johnyb97/ECUS-master/hardware/ECUS-FSE-07.kicad_pcb

## KiCad design hardware/ECUS-FSE-07.kicad_pcb (2018-09-02)

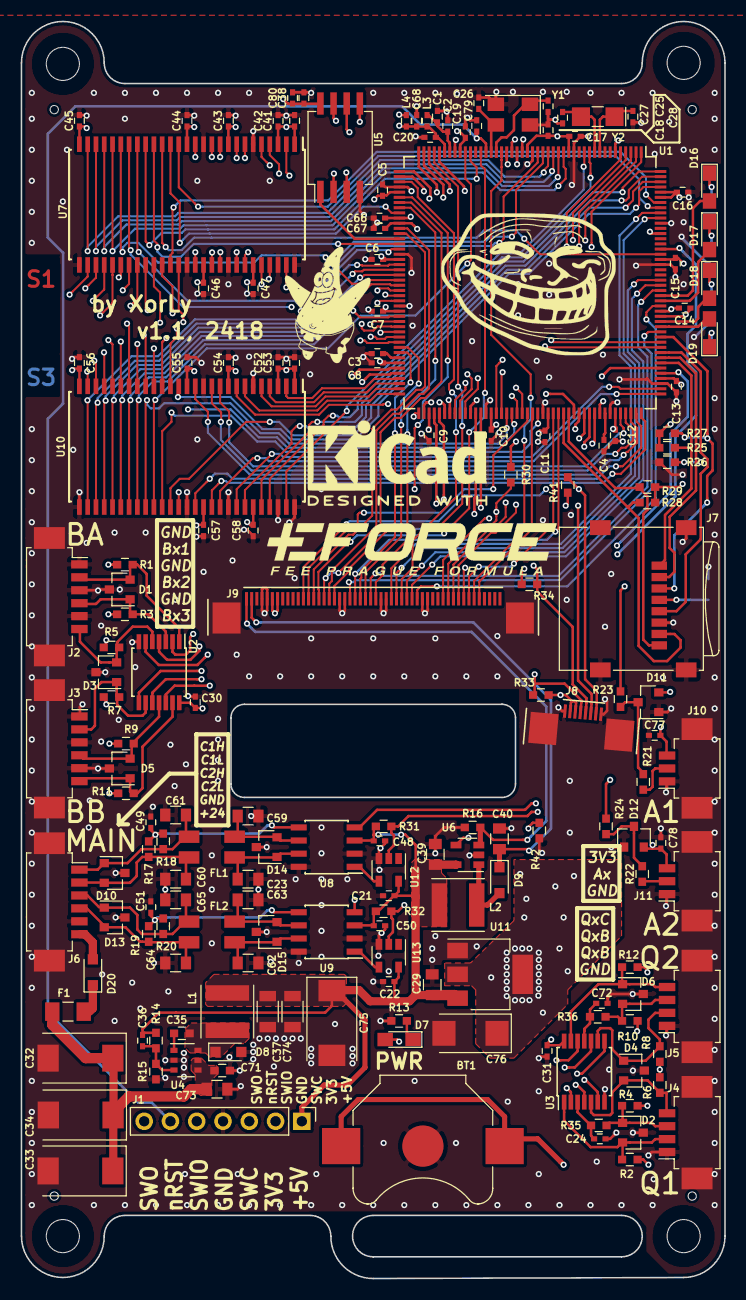
[picture p1: board ECUS-FSE-07.kicad_pcb from above]

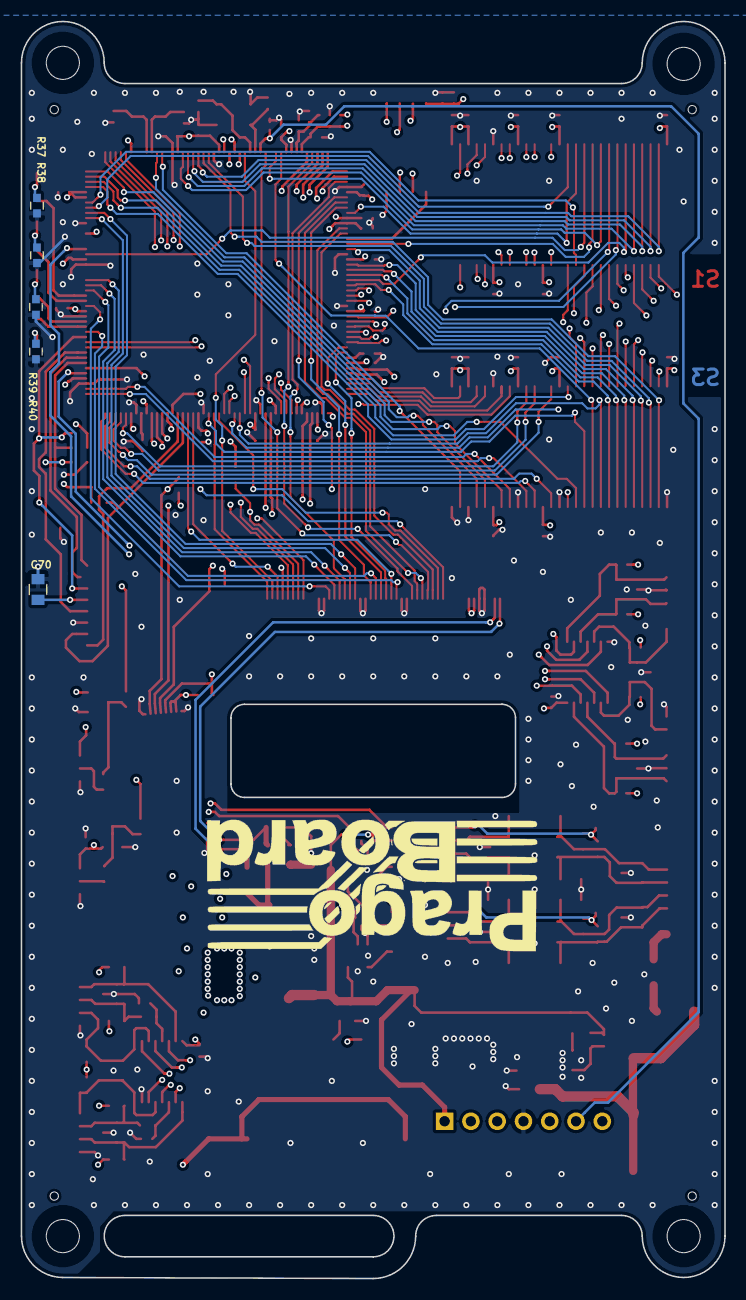
[picture p2: board ECUS-FSE-07.kicad_pcb from below]

Board: 6 copper layers, 68.0 x 121.5 mm, 189 parts (6 on the bottom side), 184 nets.

Parts:
BT1: BR-1225/VCN; Keystone_3000_1x12mm-CoinCell
C1, C3, C4, C68: 2.2u; C_0402_1005Metric_legacy
C2, C5, C6, C7, C8, C9, C10, C11, C12, C13, C14, C15, C16, C17, C18, C19, C20, C21, C22, C24, C30, C31, C36, C38, C48, C50, C72, C79: 100n; C_0402_1005Metric_legacy
C23, C59, C60, C61, C62, C63, C64, C65: Can; C_0805_2012Metric_legacy
C25, C26: 33p; C_0402_1005Metric_legacy
C27, C28: 15p; C_0402_1005Metric_legacy
C29, C39: 4.7u; C_0805_2012Metric_legacy
C32, C33, C34: 10u/35V; CP_EIA-7343-31_Kemet-D
C35: 15n/50V; C_0603_1608Metric_legacy
C37, C74: 10u; C_1206_3216Metric_legacy
C40: 220n/35V; C_0805_2012Metric_legacy
C41, C42, C43, C44, C45, C46, C47, C49, C51, C52, C53, C54, C55, C56, C57, C58: 10n; C_0402_1005Metric_legacy
C66, C67: Cain; C_0402_1005Metric_legacy
C70: 4u; C_0805_2012Metric_legacy
C71: 100n/50V; C_0603_1608Metric_legacy
C73: 1u/50V; C_0805_2012Metric_legacy
C75: 100u/10V; CP_EIA-7343-31_Kemet-D
C76: 22u/16V; CP_EIA-6032-28_Kemet-C_Pad2.24x2.40mm_HandSolder
C77, C78: C; C_0402_1005Metric_legacy
C80: 1u; C_0402_1005Metric_legacy
D1, D2, D3, D4, D5, D6: D_TVS_UNI_x2_CCA; SOT-23
D7: PWR; LED_0805_2012Metric_Pad0.97x1.50mm_HandSolder
D8, D9, D20: D_Schottky; D_SOD-323_HandSoldering
D10, D13, D14, D15: NUP2105L; SOT-23
D11, D12: BAV99; SOT-23
D16: LED1; LED_0805_2012Metric_Pad0.97x1.50mm_HandSolder
D17: LED2; LED_0805_2012Metric_Pad0.97x1.50mm_HandSolder
D18: LED3; LED_0805_2012Metric_Pad0.97x1.50mm_HandSolder
D19: LED4; LED_0805_2012Metric_Pad0.97x1.50mm_HandSolder
F1: Fuse; Fuse_1206_3216Metric_Pad1.39x1.80mm_HandSolder
FL1, FL2: EMI_Filter_LL; DLW43
J1: DBG; PinHeader_1x07_P2.54mm_Vertical
J2: BTN_A; Molex_PicoBlade_53261-0671_1x06-1MP_P1.25mm_Horizontal
J3: BTN_B; Molex_PicoBlade_53261-0671_1x06-1MP_P1.25mm_Horizontal
J4: QEI1; Molex_PicoBlade_53261-0471_1x04-1MP_P1.25mm_Horizontal
J5: QEI2; Molex_PicoBlade_53261-0471_1x04-1MP_P1.25mm_Horizontal
J6: main; Molex_PicoBlade_53261-0671_1x06-1MP_P1.25mm_Horizontal
J7: Micro_SD_Card_Det; microSD_HC_Wuerth_693072010801
J8: TC; FPC_08_0.5
J9: LCD; FPC_50_0.5
J10, J11: AIN; Molex_PicoBlade_53261-0371_1x03-1MP_P1.25mm_Horizontal
L1: 6.8u; L_Taiyo-Yuden_NR-50xx
L2: 33u; L_Taiyo-Yuden_NR-50xx
L3, L4: Ferrite_Bead_Small; C_0402_1005Metric_legacy
M1: DISPLAY_MODEL; LCD_ECUS
M2: eforce; eforce_28
M3: pragoboard
M4: bonus; troll_24
M5: kicad; kicad_18
M6: patrick; patrick_11
MK1, MK2, MK3, MK4: Mounting_Hole; MountingHole_3.2mm_M3_NoMask
MK5, MK6, MK7, MK8: LCD_Hole; Hole_0.8
R1, R2, R3, R4, R5, R6, R7, R8, R9, R10, R11, R12, R31, R32, R35, R36, R42: 1k; R_0603_larger_pads
R13, R37, R38, R39, R40: Rled; R_0603_larger_pads
R14: 3.9k; R_0603_larger_pads
R15: 680; R_0603_larger_pads
R16: 15; R_0603_larger_pads
R17, R18, R19, R20: 60; R_0603_larger_pads
R21, R22: Rain; R_0603_larger_pads
R23, R24: Rain2; R_0603_larger_pads
R25, R27, R28, R29: RuSD; R_0603_larger_pads
R26: RdSD; R_0603_larger_pads
R30, R41: 10k; R_0603_larger_pads
R33, R34: 4.7k; R_0603_larger_pads
U1: STM32F746IETx; LQFP-176_24x24mm_P0.5mm
U2, U3: 74LVC04; TSSOP-14_4.4x5mm_P0.65mm
U4: BD9G101G; TSOP-6_1.65x3.05mm_P0.95mm
U5: N25Q128A; SSO-8_6.8x5.9mm_P1.27mm_Clearance7mm
U6: CAT4237; SOT-23-5
U7, U10: IS42S16400; TSOP_II_54_10.16x22.22_Pitch0.8mm
U8, U9: TJA1049T; SOIC-8_3.9x4.9mm_P1.27mm
U11: AP1117-33; SOT-223-3_TabPin2
U12, U13: 74LVC1G17; SOT-23-5
Y1: 8MHz 18pF; Crystal_SMD_5032-4Pin_5.0x3.2mm
Y2: 32.768 kHz 9pF; Crystal_SMD_MicroCrystal_CC7V-T1A-2Pin_3.2x1.5mm_HandSolder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

Connections:
+3V3: C5.1, C6.1, C7.1, C8.1, C9.1, C10.1, C11.1, C12.1, C13.1, C14.1, C15.1, C16.1, C17.1, C18.1, C19.1, C30.1, C31.1, C38.1, C41.1, C42.1, C43.1, C44.1, C45.1, C46.1, C47.1, C52.1, C53.1, C54.1, C55.1, C56.1, C57.1, C58.1, C70.1, C76.1, C77.2, C78.2, C80.1, D7.2, D11.2, D12.2, J1.2, J7.4, J8.2, J8.3, J9.6, J9.7, J10.3, J11.3, L4.2, R1.1, R2.1, R3.1, R4.1, R5.1, R6.1, R7.1, R8.1, R9.1, R10.1, R11.1, R12.1, R25.1, R27.1, R28.1, R29.1, R30.1, R33.1, R34.1, R41.1, U1.15, U1.23, U1.36, U1.49, U1.62, U1.72, U1.82, U1.91, U1.103, U1.114, U1.127, U1.136, U1.149, U1.159, U1.171, U1.172, U2.14, U3.14, U5.8, U7.1, U7.3, U7.9, U7.14, U7.27, U7.43, U7.49, U10.1, U10.3, U10.9, U10.14, U10.27, U10.43, U10.49, U11.2
+5V: C21.1, C22.1, C29.1, C36.1, C37.1, C39.1, C48.1, C50.1, C74.1, C75.1, J1.1, L1.2, L2.1, R14.1, R31.1, R32.1, U6.5, U8.3, U9.3, U11.3, U12.5, U13.5
+24V: C32.1, C33.1, C34.1, C71.1, C73.1, F1.2, U4.4, U4.5
/AIN_1: C66.2, R23.2, U1.54
/AIN_2: C67.2, R24.2, U1.55
/BTN_A1: U1.83, U2.2
/BTN_A2: U1.84, U2.4
/BTN_A3: U1.94, U2.6
/BTN_B1: U1.95, U2.8
/BTN_B2: U1.99, U2.10
/BTN_B3: U1.119, U2.12
/CAN1_H: C60.1, D10.2, FL1.2, J6.2, R17.1
/CAN1_L: C61.1, D10.1, FL1.4, J6.1, R18.2
/CAN1_RX: U1.122, U8.4
/CAN1_TX: R31.2, U1.123, U12.2
/CAN2_H: C64.1, D13.2, FL2.2, J6.4, R19.1
/CAN2_L: C65.1, D13.1, FL2.4, J6.3, R20.2
/CAN2_RX: U1.92, U9.4
/CAN2_TX: R32.2, U1.93, U13.2
/FLASH_CLK: U1.58, U5.1
/FLASH_IO0: U1.26, U5.5
/FLASH_IO1: U1.27, U5.2
/FLASH_IO2: U1.25, U5.3
/FLASH_IO3: U1.24, U5.7
/FLASH_nCS: U1.164, U5.6
/I2C4_SCL: J8.4, R33.2, U1.100
/I2C4_SDA: J8.5, R34.2, U1.101
/LCD/LED_A: C40.1, D9.1, J9.2
/LCD/LED_K: J9.1, R16.1, U6.3
/LCD_B2: J9.34, U1.150
/LCD_B3: J9.33, U1.154
/LCD_B4: J9.32, U1.155
/LCD_B5: J9.31, U1.47
/LCD_B6: J9.30, U1.167
/LCD_B7: J9.29, U1.168
/LCD_BLCTL: R42.1, U1.138, U6.4
/LCD_CLK: J9.46, U1.111
/LCD_CTL_MISO: J9.42, U1.4
/LCD_CTL_MOSI: J9.41, U1.5
/LCD_CTL_RST: J9.12, U1.2
/LCD_CTL_SCK: J9.39, U1.1
/LCD_CTL_~CS: J9.40, R30.2, U1.3
/LCD_DE: J9.45, U1.28
/LCD_G2: J9.26, U1.52
/LCD_G3: J9.25, U1.153
/LCD_G4: J9.24, U1.79
/LCD_G5: J9.23, U1.80
/LCD_G6: J9.22, U1.116
/LCD_G7: J9.21, U1.145
/LCD_HSYNC: J9.44, U1.115
/LCD_R2: J9.18, U1.41
/LCD_R3: J9.17, U1.56
/LCD_R4: J9.16, U1.51
/LCD_R5: J9.15, U1.32
/LCD_R6: J9.14, U1.57
/LCD_R7: J9.13, U1.110
/LCD_VSYNC: J9.43, U1.50
/LED1: D16.2, U1.152
/LED2: D17.2, U1.151
/LED3: D18.2, U1.147
/LED4: D19.2, U1.146
/QE1_A: U1.40, U3.2
/QE1_B: U1.42, U3.4
/QE1_C: U1.43, U3.6
/QE2_A: U1.44, U3.8
/QE2_B: U1.45, U3.10
/QE2_C: U1.46, U3.12
/RAM_A0: U1.16, U7.23, U10.23
/RAM_A1: U1.17, U7.24, U10.24
/RAM_A2: U1.18, U7.25, U10.25
/RAM_A3: U1.19, U7.26, U10.26
/RAM_A4: U1.20, U7.29, U10.29
/RAM_A5: U1.21, U7.30, U10.30
/RAM_A6: U1.60, U7.31, U10.31
/RAM_A7: U1.63, U7.32, U10.32
/RAM_A8: U1.64, U7.33, U10.33
/RAM_A9: U1.65, U7.34, U10.34
/RAM_A10: U1.66, U7.22, U10.22
/RAM_A11: U1.67, U7.35, U10.35
/RAM_A12: U1.106, U7.36, U10.36
/RAM_A13: U1.107, U7.40, U10.40
/RAM_BA0: U1.108, U7.20, U10.20
/RAM_BA1: U1.109, U7.21, U10.21
/RAM_CAS: U1.160, U7.17, U10.17
/RAM_CKE: U1.35, U7.37, U10.37
/RAM_CLK: U1.112, U7.38, U10.38
/RAM_CS: U1.34, U7.19, U10.19
/RAM_DE0: U1.169, U7.15
/RAM_DE1: U1.170, U7.39
/RAM_DE2: U1.173, U10.15
/RAM_DE3: U1.174, U10.39
/RAM_DH0: U1.85, U10.2
/RAM_DH1: U1.86, U10.4
/RAM_DH2: U1.87, U10.5
/RAM_DH3: U1.88, U10.7
/RAM_DH4: U1.89, U10.8
/RAM_DH5: U1.128, U10.10
/RAM_DH6: U1.129, U10.11
/RAM_DH7: U1.130, U10.13
/RAM_DH8: U1.131, U10.42
/RAM_DH9: U1.132, U10.44
/RAM_DH10: U1.133, U10.45
/RAM_DH11: U1.134, U10.47
/RAM_DH12: U1.175, U10.48
/RAM_DH13: U1.176, U10.50
/RAM_DH14: U1.11, U10.51
/RAM_DH15: U1.12, U10.53
/RAM_DL0: U1.104, U7.2
/RAM_DL1: U1.105, U7.4
/RAM_DL2: U1.142, U7.5
/RAM_DL3: U1.143, U7.7
/RAM_DL4: U1.68, U7.8
/RAM_DL5: U1.69, U7.10
/RAM_DL6: U1.70, U7.11
/RAM_DL7: U1.73, U7.13
/RAM_DL8: U1.74, U7.42
/RAM_DL9: U1.75, U7.44
/RAM_DL10: U1.76, U7.45
/RAM_DL11: U1.77, U7.47
/RAM_DL12: U1.78, U7.48
/RAM_DL13: U1.96, U7.50
/RAM_DL14: U1.97, U7.51
/RAM_DL15: U1.98, U7.53
/RAM_RAS: U1.59, U7.18, U10.18
/RAM_WE: U1.53, U7.16, U10.16
/SD_CLK: J7.5, U1.141
/SD_CMD: J7.3, R27.2, U1.144
/SD_DAT0: J7.7, R28.2, U1.117
/SD_DAT1: J7.8, R29.2, U1.118
/SD_DAT2: J7.1, R25.2, U1.139
/SD_DAT3: J7.2, R26.1, U1.140
/SWCLK: J1.3, U1.137
/SWDIO: J1.5, U1.124
/SWO: J1.7, U1.161
/TC_INT: J8.6, U1.120
/TC_RST: J8.7, R41.2, U1.121
/VDDA: C20.1, C68.1, L3.1, L4.1, U1.39
/XTAL32_IN: C27.1, U1.9, Y2.1
/XTAL32_OUT: C28.1, U1.10, Y2.2
/XTAL_IN: C25.1, U1.29, Y1.1
/XTAL_OUT: C26.1, U1.30, Y1.3
/nRST: C79.1, J1.6, U1.31
GND: BT1.2, C1.2, C2.2, C3.2, C4.2, C5.2, C6.2, C7.2, C8.2, C9.2, C10.2, C11.2, C12.2, C13.2, C14.2, C15.2, C16.2, C17.2, C18.2, C19.2, C20.2, C21.2, C22.2, C23.2, C24.2, C25.2, C26.2, C27.2, C28.2, C29.2, C30.2, C31.2, C32.2, C33.2, C34.2, C37.2, C38.2, C39.2, C40.2, C41.2, C42.2, C43.2, C44.2, C45.2, C46.2, C47.2, C48.2, C49.2, C50.2, C51.2, C52.2, C53.2, C54.2, C55.2, C56.2, C57.2, C58.2, C59.2, C60.2, C61.2, C62.2, C63.2, C64.2, C65.2, C66.1, C67.1, C68.2, C70.2, C71.2, C72.2, C73.2, C74.2, C75.2, C76.2, C77.1, C78.1, C79.2, C80.2, D1.3, D2.3, D3.3, D4.3, D5.3, D6.3, D8.2, D10.3, D11.1, D12.1, D13.3, D14.3, D15.3, J1.4, J2.1, J2.3, J2.5, J2.MP, J3.1, J3.3, J3.5, J3.MP, J4.1, J4.MP, J5.1, J5.MP, J6.5, J6.MP, J7.6, J7.9, J8.1, J8.8, J8.MP, J9.4, J9.5, J9.19, J9.20, J9.27, J9.28, J9.35, J9.36, J9.MP, J10.1, J10.MP, J11.1, J11.MP, R13.2, R15.2, R16.2, R26.2, R37.2, R38.2, R39.2, R40.2, R42.2, U1.14, U1.22, U1.37, U1.48, U1.61, U1.71, U1.90, U1.102, U1.113, U1.126, U1.135, U1.148, U1.158, U1.166, U2.7, U3.7, U4.2, U5.4, U6.2, U7.6, U7.12, U7.28, U7.41, U7.46, U7.52, U7.54, U8.2, U8.8, U9.2, U9.8, U10.6, U10.12, U10.28, U10.41, U10.46, U10.52, U10.54, U11.1, U12.3, U13.3, Y1.2, Y1.4
unnamed: BT1.1, U1.6
unnamed: C1.1, C2.1, L3.2, U1.38
unnamed: C3.1, U1.81
unnamed: C4.1, U1.125
unnamed: C23.1, D14.1, FL1.1, U8.7
unnamed: C24.1, R35.1, U3.3
unnamed: C35.1, D8.1, L1.1, U4.6
unnamed: C35.2, U4.1
unnamed: C36.2, R14.2, R15.1, U4.3
unnamed: C49.1, R17.2, R18.1, U8.5
unnamed: C51.1, R19.2, R20.1, U9.5
unnamed: C59.1, D14.2, FL1.3, U8.6
unnamed: C62.1, D15.1, FL2.1, U9.7
unnamed: C63.1, D15.2, FL2.3, U9.6
unnamed: C72.1, R36.1, U3.11
unnamed: D1.1, J2.4, R3.2, U2.3
unnamed: D1.2, J2.2, R1.2, U2.1
unnamed: D2.1, J4.3, R4.2, R35.2
unnamed: D2.2, J4.2, R2.2, U3.1
unnamed: D3.1, J3.2, R7.2, U2.9
unnamed: D3.2, J2.6, R5.2, U2.5
unnamed: D4.1, J5.2, R8.2, U3.9
unnamed: D4.2, J4.4, R6.2, U3.5
unnamed: D5.1, J3.6, R11.2, U2.13
unnamed: D5.2, J3.4, R9.2, U2.11
unnamed: D6.1, J5.4, R12.2, U3.13
unnamed: D6.2, J5.3, R10.2, R36.2
unnamed: D7.1, R13.1
unnamed: D9.2, L2.2, U6.1
unnamed: D11.3, R21.2, R23.1
unnamed: D12.3, R22.2, R24.1
unnamed: D16.1, R37.1
unnamed: D17.1, R38.1
unnamed: D18.1, R39.1
unnamed: D19.1, R40.1
unnamed: D20.1, F1.1
unnamed: D20.2, J6.6
unnamed: J10.2, R21.1
unnamed: J11.2, R22.1
unnamed: U8.1, U12.4
unnamed: U9.1, U13.4
