johnyb97/ECUS-master/code/candb_structure.c

//by xorly

#include "candb_structure.h"

#ifndef NULL
	#define NULL ( (void *) 0)
#endif


const candb_descrition_map_t *const ECUA_AIRsState_descriptions[]={
	(const candb_descrition_map_t[]){{ CANDB_ECUA_AIRSSTATE_ECUA_PENDINGCHARGERDETECT, "Awaiting detection of car or charger" }},
	(const candb_descrition_map_t[]){{ CANDB_ECUA_AIRSSTATE_ECUA_READY, "Awaiting SDC completion to begin precharge" }},
	(const candb_descrition_map_t[]){{ CANDB_ECUA_AIRSSTATE_ECUA_STARTUPCHECK, "Startup check" }},
	(const candb_descrition_map_t[]){{ CANDB_ECUA_AIRSSTATE_ECUA_PRECHARGECLOSING, "Precharge relay is being closed" }},
	(const candb_descrition_map_t[]){{ CANDB_ECUA_AIRSSTATE_ECUA_HVMCLOSING, "HV- relay is being closed" }},
	(const candb_descrition_map_t[]){{ CANDB_ECUA_AIRSSTATE_ECUA_PRECHARGING, "Precharge part 1: blind delay" }},
	(const candb_descrition_map_t[]){{ CANDB_ECUA_AIRSSTATE_ECUA_WAITINGFORVDIFF, "Precharge part 2: wait for ΔV to approach zero" }},
	(const candb_descrition_map_t[]){{ CANDB_ECUA_AIRSSTATE_ECUA_HVPCLOSING, "HV+ relay is being closed" }},
	(const candb_descrition_map_t[]){{ CANDB_ECUA_AIRSSTATE_ECUA_ENDPRECHARGE, "Precharge is finishing" }},
	(const candb_descrition_map_t[]){{ CANDB_ECUA_AIRSSTATE_ECUA_TSACTIVE, "TS is charged and active" }},
	(const candb_descrition_map_t[]){{ CANDB_ECUA_AIRSSTATE_ECUA_FATALERROR, "A fatal error occured and the AMS is latched" }},
	(const candb_descrition_map_t[]){{ CANDB_ECUA_AIRSSTATE_ECUA_COOLDOWN, "Precharge failed, cooling down before retrying" }},
	(const candb_descrition_map_t[]){{ CANDB_ECUA_AIRSSTATE_ECUA_HVMCOOLDOWN, "HV- failed to close, cooling down before retrying" }},
NULL};
const candb_descrition_map_t *const ECUA_StateAMS_descriptions[]={
	(const candb_descrition_map_t[]){{ CANDB_ECUA_STATEAMS_ECUA_ALL_OK, "without_fault" }},
	(const candb_descrition_map_t[]){{ CANDB_ECUA_STATEAMS_ECUA_SHIT, "All_fucked" }},
NULL};
const candb_descrition_map_t *const ECUA_ErrorCode_descriptions[]={
	(const candb_descrition_map_t[]){{ CANDB_ECUA_ERRORCODE_ECUA_OK, "no error" }},
	(const candb_descrition_map_t[]){{ CANDB_ECUA_ERRORCODE_ECUA_SDC_TIMEOUT, "unused" }},
	(const candb_descrition_map_t[]){{ CANDB_ECUA_ERRORCODE_ECUA_HVM_MELT, "HV- closed even though it shouldn't be" }},
	(const candb_descrition_map_t[]){{ CANDB_ECUA_ERRORCODE_ECUA_HVP_MELT, "HV+ closed even though it shouldn't be" }},
	(const candb_descrition_map_t[]){{ CANDB_ECUA_ERRORCODE_ECUA_HVM_TIMEOUT, "HV- didn't close in time" }},
	(const candb_descrition_map_t[]){{ CANDB_ECUA_ERRORCODE_ECUA_HVP_TIMEOUT, "HV+ didn't close in time" }},
	(const candb_descrition_map_t[]){{ CANDB_ECUA_ERRORCODE_ECUA_VDIFF_TIMEOUT, "precharge failed to equaize AIRs x Accu voltage" }},
	(const candb_descrition_map_t[]){{ CANDB_ECUA_ERRORCODE_ECUA_SDC_INTERRUPTED, "SDC interrupted unexpectedly" }},
	(const candb_descrition_map_t[]){{ CANDB_ECUA_ERRORCODE_ECUA_HVM_DISCONNECT, "HV- broke open" }},
	(const candb_descrition_map_t[]){{ CANDB_ECUA_ERRORCODE_ECUA_HVP_DISCONNECT, "HV+ broke open" }},
	(const candb_descrition_map_t[]){{ CANDB_ECUA_ERRORCODE_ECUA_BMS_CELL_MIN_VOLTAGE, "Voltage of a cell is too low" }},
	(const candb_descrition_map_t[]){{ CANDB_ECUA_ERRORCODE_ECUA_BMS_CELL_BALANCE, "Imbalance between some cells is too high" }},
	(const candb_descrition_map_t[]){{ CANDB_ECUA_ERRORCODE_ECUA_BMS_CELL_TEMPERATURE, "Too hot!" }},
	(const candb_descrition_map_t[]){{ CANDB_ECUA_ERRORCODE_ECUA_BMS_COMMUNICATION, "BMS communication error - probably not connected" }},
	(const candb_descrition_map_t[]){{ CANDB_ECUA_ERRORCODE_ECUA_TOO_MANY_ERRORS, "Too many non-fatal errors => escalated to a fatal error" }},
NULL};
const candb_descrition_map_t *const ECUB_Batt_code_descriptions[]={
	(const candb_descrition_map_t[]){{ CANDB_ECUB_BATT_CODE_ECUB_IDLE, "No power drawn nor charged" }},
	(const candb_descrition_map_t[]){{ CANDB_ECUB_BATT_CODE_ECUB_CHARGING, "Charging with balancing" }},
	(const candb_descrition_map_t[]){{ CANDB_ECUB_BATT_CODE_ECUB_FAST_CHARGING, "Charging without balancing" }},
	(const candb_descrition_map_t[]){{ CANDB_ECUB_BATT_CODE_ECUB_BALANCING, "Only balancing" }},
	(const candb_descrition_map_t[]){{ CANDB_ECUB_BATT_CODE_ECUB_DISCHARGING, "Is being discharged" }},
	(const candb_descrition_map_t[]){{ CANDB_ECUB_BATT_CODE_ECUB_FULL, "Fully charged" }},
	(const candb_descrition_map_t[]){{ CANDB_ECUB_BATT_CODE_ECUB_ERROR, "Is in error state" }},
NULL};
const candb_descrition_map_t *const ECUB_CarState_descriptions[]={
	(const candb_descrition_map_t[]){{ CANDB_ECUB_CARSTATE_ECUB_NOT_READY, "SDC interrupted -> not ready for start" }},
	(const candb_descrition_map_t[]){{ CANDB_ECUB_CARSTATE_ECUB_LATCHED, "Fatal error \w SDC latching" }},
	(const candb_descrition_map_t[]){{ CANDB_ECUB_CARSTATE_ECUB_TS_READY, "Ready for TSON button" }},
	(const candb_descrition_map_t[]){{ CANDB_ECUB_CARSTATE_ECUB_PRECHARGE, "ACP is being precharged -> waiting for ECUA status" }},
	(const candb_descrition_map_t[]){{ CANDB_ECUB_CARSTATE_ECUB_TS_ON, "Ready for START" }},
	(const candb_descrition_map_t[]){{ CANDB_ECUB_CARSTATE_ECUB_WAITING_FOR_RTDS, "Waiting for completion of RTDS" }},
	(const candb_descrition_map_t[]){{ CANDB_ECUB_CARSTATE_ECUB_STARTED, "Drive!" }},
NULL};
const candb_descrition_map_t *const ECUB_GLV_PowerSource_descriptions[]={
	(const candb_descrition_map_t[]){{ CANDB_ECUB_GLV_POWERSOURCE_ECUB_ACP, "ACP" }},
	(const candb_descrition_map_t[]){{ CANDB_ECUB_GLV_POWERSOURCE_ECUB_GLV_BATTERY, "GLV battery" }},
	(const candb_descrition_map_t[]){{ CANDB_ECUB_GLV_POWERSOURCE_ECUB_SERVICE_INPUT, "Service box input" }},
NULL};
const candb_descrition_map_t *const ECUB_Notready_reason_descriptions[]={
	(const candb_descrition_map_t[]){{ CANDB_ECUB_NOTREADY_REASON_ECUB_NONE, "No error" }},
	(const candb_descrition_map_t[]){{ CANDB_ECUB_NOTREADY_REASON_ECUB_LATCH_START, "Vehicle was latched at the startup" }},
	(const candb_descrition_map_t[]){{ CANDB_ECUB_NOTREADY_REASON_ECUB_LATCH_BSPD, "Vehicle was latched due to BSPD error" }},
	(const candb_descrition_map_t[]){{ CANDB_ECUB_NOTREADY_REASON_ECUB_LATCH_AMS, "Vehicle was latched due to AMS error" }},
	(const candb_descrition_map_t[]){{ CANDB_ECUB_NOTREADY_REASON_ECUB_SDC_FAILURE, "Error in SDC chain" }},
	(const candb_descrition_map_t[]){{ CANDB_ECUB_NOTREADY_REASON_ECUB_TIMEOUT_MC, "Motor controller CAN timeout" }},
	(const candb_descrition_map_t[]){{ CANDB_ECUB_NOTREADY_REASON_ECUB_TIMEOUT_ECUA, "AMS CAN timeout" }},
	(const candb_descrition_map_t[]){{ CANDB_ECUB_NOTREADY_REASON_ECUB_TIMEOUT_ECUF, "ECU Front CAN timeout" }},
	(const candb_descrition_map_t[]){{ CANDB_ECUB_NOTREADY_REASON_ECUB_TIMEOUT_ECUP, "Pedal unit CAN timeout" }},
	(const candb_descrition_map_t[]){{ CANDB_ECUB_NOTREADY_REASON_ECUB_TIMEOUT_VDCU, "VDCU CAN timeout" }},
	(const candb_descrition_map_t[]){{ CANDB_ECUB_NOTREADY_REASON_ECUB_PWM_FAULT, "Fault on PWM_fault pins" }},
NULL};
const candb_descrition_map_t *const ECUP_CAL_PedalIndex_descriptions[]={
	(const candb_descrition_map_t[]){{ CANDB_ECUP_CAL_PEDALINDEX_ECUP_NONE, "None" }},
	(const candb_descrition_map_t[]){{ CANDB_ECUP_CAL_PEDALINDEX_ECUP_APPSMIN, "Minimum apps position" }},
	(const candb_descrition_map_t[]){{ CANDB_ECUP_CAL_PEDALINDEX_ECUP_APPSMAX, "Maximum apps position" }},
	(const candb_descrition_map_t[]){{ CANDB_ECUP_CAL_PEDALINDEX_ECUP_BRAKEMIN, "Minimum brake position" }},
	(const candb_descrition_map_t[]){{ CANDB_ECUP_CAL_PEDALINDEX_ECUP_BRAKEMAX, "Maximum brake position" }},
	(const candb_descrition_map_t[]){{ CANDB_ECUP_CAL_PEDALINDEX_ECUP_REGENMAX, "Maximum regenerative position" }},
NULL};
const candb_descrition_map_t *const ECUP_CalibrationIndex_descriptions[]={
	(const candb_descrition_map_t[]){{ CANDB_ECUP_CALIBRATIONINDEX_ECUP_DUMMY, "FIX THIS SHIT" }},
NULL};
const candb_descrition_map_t *const VDCU_CAL_DisIndex_descriptions[]={
	(const candb_descrition_map_t[]){{ CANDB_VDCU_CAL_DISINDEX_VDCU_NONE, "None" }},
	(const candb_descrition_map_t[]){{ CANDB_VDCU_CAL_DISINDEX_VDCU_DISFR, "Front right displacement sensor calibration" }},
	(const candb_descrition_map_t[]){{ CANDB_VDCU_CAL_DISINDEX_VDCU_DISFL, "Front left displacement sensor calibration" }},
	(const candb_descrition_map_t[]){{ CANDB_VDCU_CAL_DISINDEX_VDCU_DISRR, "Rear right displacement sensor calibration" }},
	(const candb_descrition_map_t[]){{ CANDB_VDCU_CAL_DISINDEX_VDCU_DISRL, "Rear left displacement sensor calibration" }},
NULL};
const candb_descrition_map_t *const VDCU_VDCU_Param_descriptions[]={
	(const candb_descrition_map_t[]){{ CANDB_VDCU_VDCU_PARAM_VDCU_TRQ_GAIN, "Torque gain (0-100)" }},
	(const candb_descrition_map_t[]){{ CANDB_VDCU_VDCU_PARAM_VDCU_TRQ_MAXFRONT, "Maximum torque for front axle (0-100)" }},
	(const candb_descrition_map_t[]){{ CANDB_VDCU_VDCU_PARAM_VDCU_TRQ_MAXREAR, "Maximum torque for rear axle (0-100)" }},
	(const candb_descrition_map_t[]){{ CANDB_VDCU_VDCU_PARAM_VDCU_PWRLIM, "Maximum power in kW (0-140)" }},
	(const candb_descrition_map_t[]){{ CANDB_VDCU_VDCU_PARAM_VDCU_GEN_PWRLIM, "Maximum regenerative power in kW (0-40)" }},
	(const candb_descrition_map_t[]){{ CANDB_VDCU_VDCU_PARAM_VDCU_PED_MAP, "Pedal map selector (0-4)" }},
	(const candb_descrition_map_t[]){{ CANDB_VDCU_VDCU_PARAM_VDCU_TV_DISTRIB, "Torque distribution to rear (0-100)" }},
	(const candb_descrition_map_t[]){{ CANDB_VDCU_VDCU_PARAM_VDCU_TV_FRONT_GAIN, "Torque vectoring gain on front axle (0-200)" }},
	(const candb_descrition_map_t[]){{ CANDB_VDCU_VDCU_PARAM_VDCU_TV_REAR_GAIN, "Torque vectoring gain on rear axle (0-200)" }},
	(const candb_descrition_map_t[]){{ CANDB_VDCU_VDCU_PARAM_VDCU_TV_SPEED_DECLINE, "Torque  vectoring speed decline (0-100)" }},
	(const candb_descrition_map_t[]){{ CANDB_VDCU_VDCU_PARAM_VDCU_TC_SLIP_SP, "Slip ratio controller slip setpoint (4-20)" }},
	(const candb_descrition_map_t[]){{ CANDB_VDCU_VDCU_PARAM_VDCU_YC_REF_GAIN, "Yaw rate controller reference gain (0-200)" }},
	(const candb_descrition_map_t[]){{ CANDB_VDCU_VDCU_PARAM_VDCU_YC_GAIN, "Yaw controller output gain (0-200)" }},
	(const candb_descrition_map_t[]){{ CANDB_VDCU_VDCU_PARAM_VDCU_FIELDWEAK, "Field weakening (0-100)" }},
	(const candb_descrition_map_t[]){{ CANDB_VDCU_VDCU_PARAM_VDCU_REVERSE_REQ, "Request for reverse [0,1] (not a parameter)" }},
	(const candb_descrition_map_t[]){{ CANDB_VDCU_VDCU_PARAM_VDCU_RACEMODE_REQ, "Racing mode (0-11) (OFF,accel, skid, autox, endu, fun, amateur, transport ...)" }},
	(const candb_descrition_map_t[]){{ CANDB_VDCU_VDCU_PARAM_VDCU_TV_EN, "TorqueVectoring (distribution) enable" }},
	(const candb_descrition_map_t[]){{ CANDB_VDCU_VDCU_PARAM_VDCU_GEN_EN, "ENABLE regenerative braking [0,1]" }},
	(const candb_descrition_map_t[]){{ CANDB_VDCU_VDCU_PARAM_VDCU_BOOST_EN, "ENABLE unlimited performance [0,1]" }},
	(const candb_descrition_map_t[]){{ CANDB_VDCU_VDCU_PARAM_VDCU_TRQ_SPEED_DECLINE, "Torque speed limitation ramp (0-100)" }},
	(const candb_descrition_map_t[]){{ CANDB_VDCU_VDCU_PARAM_VDCU_TC_THRESHOLD, "Slip ratio controller threshold (0-10)" }},
	(const candb_descrition_map_t[]){{ CANDB_VDCU_VDCU_PARAM_VDCU_TC_KP, "Slip ratio controller Kp gain (0-200)" }},
	(const candb_descrition_map_t[]){{ CANDB_VDCU_VDCU_PARAM_VDCU_TC_KI, "Slip ratio controller Ki gain (0-200)" }},
	(const candb_descrition_map_t[]){{ CANDB_VDCU_VDCU_PARAM_VDCU_TC_KB, "Slip ratio controller Kb gain(0-100)" }},
	(const candb_descrition_map_t[]){{ CANDB_VDCU_VDCU_PARAM_VDCU_YC_SPEED_DECLINE, "Yaw controller Speed limitation ramp (0-100)" }},
	(const candb_descrition_map_t[]){{ CANDB_VDCU_VDCU_PARAM_VDCU_YC_KP, "Yaw controller Kp gain (0-200)" }},
	(const candb_descrition_map_t[]){{ CANDB_VDCU_VDCU_PARAM_VDCU_YC_KI, "Yaw controller Ki gain (0-200)" }},
	(const candb_descrition_map_t[]){{ CANDB_VDCU_VDCU_PARAM_VDCU_YC_KB, "Yaw controller Kb gain (0-100)" }},
	(const candb_descrition_map_t[]){{ CANDB_VDCU_VDCU_PARAM_VDCU_FEEDFORWARD_GAIN, "Feedforward gain (0-200)" }},
	(const candb_descrition_map_t[]){{ CANDB_VDCU_VDCU_PARAM_VDCU_PWRLIM_RAMP_DECLINE, "Power limiting speed ramp (0-100)" }},
NULL};
const candb_descrition_map_t *const VDCU_VDCU_State_descriptions[]={
	(const candb_descrition_map_t[]){{ CANDB_VDCU_VDCU_STATE_VDCU_STANDBY, "Waiting for RTD" }},
	(const candb_descrition_map_t[]){{ CANDB_VDCU_VDCU_STATE_VDCU_TORQUE_EN, "Torque enabled" }},
	(const candb_descrition_map_t[]){{ CANDB_VDCU_VDCU_STATE_VDCU_ERROR, "Error state" }},
NULL};
const candb_descrition_map_t *const ECUF_CAL_STWIndex_descriptions[]={
	(const candb_descrition_map_t[]){{ CANDB_ECUF_CAL_STWINDEX_ECUF_NONE, "None" }},
	(const candb_descrition_map_t[]){{ CANDB_ECUF_CAL_STWINDEX_ECUF_STWLEFT, "Left position (output is positive)" }},
	(const candb_descrition_map_t[]){{ CANDB_ECUF_CAL_STWINDEX_ECUF_STWCENTER, "Center position" }},
	(const candb_descrition_map_t[]){{ CANDB_ECUF_CAL_STWINDEX_ECUF_STWRIGHT, "Right position (output is negative)" }},
NULL};
const candb_msg_t  *const *const candb_messages=(const candb_msg_t *const []){

	(candb_msg_t []){{
	.callback=(candb_msg_callback_p[]){NULL},
	.timestamp=(uint32_t []){0},
	.description={.name="Status", .comments="Base status of ECUA and its subsystems (AMS)"},
	.sent_by="ECUA",
	.id=144,
	.length=7,
	.timeout=500,
	.period=0,
	.fields=(const candb_msg_field_t *const[]){
			(const candb_msg_field_t []){{
			.description={.name="SDC_IN_Open", .comments="Lead from ECUB (1 = open)"},
			.type=CANDB_MSG_FIELD_TYPE_BOOL,
			.unit="",
			.bits=1,
			.offset=0,
			.count=1,
			.timestamp=(uint32_t []){0},
			.type_specific.bl={
				.value=(bool []){false, },
			},
		}},
			(const candb_msg_field_t []){{
			.description={.name="SDC_HV_ILOCK", .comments="True if HV interlock is closed"},
			.type=CANDB_MSG_FIELD_TYPE_BOOL,
			.unit="",
			.bits=1,
			.offset=1,
			.count=1,
			.timestamp=(uint32_t []){0},
			.type_specific.bl={
				.value=(bool []){false, },
			},
		}},
			(const candb_msg_field_t []){{
			.description={.name="SDC_IMD", .comments="True if SDC is not broken by IMD"},
			.type=CANDB_MSG_FIELD_TYPE_BOOL,
			.unit="",
			.bits=1,
			.offset=2,
			.count=1,
			.timestamp=(uint32_t []){0},
			.type_specific.bl={
				.value=(bool []){false, },
			},
		}},
			(const candb_msg_field_t []){{
			.description={.name="SDC_AMS", .comments="AMS = ECUA+BMS"},
			.type=CANDB_MSG_FIELD_TYPE_BOOL,
			.unit="",
			.bits=1,
			.offset=3,
			.count=1,
			.timestamp=(uint32_t []){0},
			.type_specific.bl={
				.value=(bool []){false, },
			},
		}},
			(const candb_msg_field_t []){{
			.description={.name="SDC_OUT", .comments="SDC out to final stretch (BSPD etc...)"},
			.type=CANDB_MSG_FIELD_TYPE_BOOL,
			.unit="",
			.bits=1,
			.offset=4,
			.count=1,
			.timestamp=(uint32_t []){0},
			.type_specific.bl={
				.value=(bool []){false, },
			},
		}},
			(const candb_msg_field_t []){{
			.description={.name="SDC_END", .comments="End of SDC (input to AIRS)"},
			.type=CANDB_MSG_FIELD_TYPE_BOOL,
			.unit="",
			.bits=1,
			.offset=5,
			.count=1,
			.timestamp=(uint32_t []){0},
			.type_specific.bl={
				.value=(bool []){false, },
			},
		}},
			(const candb_msg_field_t []){{
			.description={.name="LATCH_SDC_AMS", .comments="HW latch engaged (caused by IMD or AMS)"},
			.type=CANDB_MSG_FIELD_TYPE_BOOL,
			.unit="",
			.bits=1,
			.offset=7,
			.count=1,
			.timestamp=(uint32_t []){0},
			.type_specific.bl={
				.value=(bool []){false, },
			},
		}},
			(const candb_msg_field_t []){{
			.description={.name="AIRsState", .comments="State of AIRs"},
			.type=CANDB_MSG_FIELD_TYPE_ENUM,
			.unit="",
			.bits=4,
			.offset=8,
			.count=1,
			.timestamp=(uint32_t []){0},
			.type_specific.en={
				.value=(uint16_t []){0},
				.descriptions=ECUA_AIRsState_descriptions,
			},
		}},
			(const candb_msg_field_t []){{
			.description={.name="AIRs_errno", .comments="AIRs error code"},
			.type=CANDB_MSG_FIELD_TYPE_UINT,
			.unit="",
			.bits=8,
			.offset=16,
			.count=1,
			.timestamp=(uint32_t []){0},
			.type_specific.num={
				.min= +0,
				.max= +0,
				.factor= +1,
				.offset= +0,
				.value=(raw32_t []){{.ui=0}, },
			},
		}},
			(const candb_msg_field_t []){{
			.description={.name="FT_ACP_OT", .comments="Fault of ACP overtemperature"},
			.type=CANDB_MSG_FIELD_TYPE_BOOL,
			.unit="",
			.bits=1,
			.offset=24,
			.count=1,
			.timestamp=(uint32_t []){0},
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
				.value=(bool []){false, },
			},
		}},
			(const candb_msg_field_t []){{
			.description={.name="charger_attached", .comments="ACP is attached to charger?"},
			.type=CANDB_MSG_FIELD_TYPE_BOOL,
			.unit="",
			.bits=1,
			.offset=45,
			.count=1,
			.timestamp=(uint32_t []){0},
			.type_specific.bl={
				.value=(bool []){false, },
			},
		}},
			(const candb_msg_field_t []){{
			.description={.name="DCDC_GLV_EN", .comments="24V power output is active"},
			.type=CANDB_MSG_FIELD_TYPE_BOOL,
			.unit="",
			.bits=1,
			.offset=46,
			.count=1,
			.timestamp=(uint32_t []){0},
			.type_specific.bl={
				.value=(bool []){false, },
			},
		}},
			(const candb_msg_field_t []){{
			.description={.name="FANS_EN", .comments="Fans are active"},
			.type=CANDB_MSG_FIELD_TYPE_BOOL,
			.unit="",
			.bits=1,
			.offset=47,
			.count=1,
			.timestamp=(uint32_t []){0},
			.type_specific.bl={
				.value=(bool []){false, },
			},
		}},
			(const candb_msg_field_t []){{
			.description={.name="SEQ", .comments="Message up counter for safety"},
			.type=CANDB_MSG_FIELD_TYPE_UINT,
			.unit="?",
			.bits=4,
			.offset=52,
			.count=1,
			.timestamp=(uint32_t []){0},
			.type_specific.num={
				.min=0,
				.max=15,
				.factor=1,
				.offset=0,
				.value=(raw32_t []){{.ui=0}, },
			},
		}},
	NULL}//end of fields array
	}},//end of message struct
	(candb_msg_t []){{
	.callback=(candb_msg_callback_p[]){NULL},
	.timestamp=(uint32_t []){0},
	.description={.name="Limits", .comments="ACP power limits that are calculated in time based on temperature and votlages. For example if undervoltage the PWR_OUT should be some few kW value to let the driver decide to risk. If ACP is full PWR_IN should be 0."},
	.sent_by="ECUA",
	.id=401,
	.length=4,
	.timeout=500,
	.period=0,
	.fields=(const candb_msg_field_t *const[]){
			(const candb_msg_field_t []){{
			.description={.name="PWR_OUT", .comments="ACP output power maximum limit"},
			.type=CANDB_MSG_FIELD_TYPE_UINT,
			.unit="W",
			.bits=16,
			.offset=0,
			.count=1,
			.timestamp=(uint32_t []){0},
			.type_specific.num={
				.min=0,
				.max=200000,
				.factor=5,
				.offset=0,
				.value=(raw32_t []){{.ui=0}, },
			},
		}},
			(const candb_msg_field_t []){{
			.description={.name="PWR_IN", .comments="ACP input power maximum limit"},
			.type=CANDB_MSG_FIELD_TYPE_UINT,
			.unit="W",
			.bits=16,
			.offset=16,
			.count=1,
			.timestamp=(uint32_t []){0},
			.type_specific.num={
				.min=0,
				.max=200000,
				.factor=5,
				.offset=0,
				.value=(raw32_t []){{.ui=0}, },
			},
		}},
	NULL}//end of fields array
	}},//end of message struct
	(candb_msg_t []){{
	.callback=(candb_msg_callback_p[]){NULL},
	.timestamp=(uint32_t []){0},
	.description={.name="ACPMeas", .comments="Main ACP measurements"},
	.sent_by="ECUA",
	.id=914,
	.length=8,
	.timeout=100,
	.period=0,
	.fields=(const candb_msg_field_t *const[]){
			(const candb_msg_field_t []){{
			.description={.name="Volt_HV_in", .comments="HV before AIRs"},
			.type=CANDB_MSG_FIELD_TYPE_UINT,
			.unit="V",
			.bits=16,
			.offset=0,
			.count=1,
			.timestamp=(uint32_t []){0},
			.type_specific.num={
				.min=0,
				.max=460,
				.factor=0.01,
				.offset=0,
				.value=(raw32_t []){{.ui=0}, },
			},
		}},
			(const candb_msg_field_t []){{
			.description={.name="Volt_HV_out", .comments="HV at output of ACP"},
			.type=CANDB_MSG_FIELD_TYPE_UINT,
			.unit="V",
			.bits=16,
			.offset=16,
			.count=1,
			.timestamp=(uint32_t []){0},
			.type_specific.num={
				.min=0,
				.max=460,
				.factor=0.01,
				.offset=0,
				.value=(raw32_t []){{.ui=0}, },
			},
		}},
			(const candb_msg_field_t []){{
			.description={.name="Curr_HV_out", .comments="HV Current (positive if energy flowing outwards)"},
			.type=CANDB_MSG_FIELD_TYPE_UINT,
			.unit="A",
			.bits=16,
			.offset=32,
			.count=1,
			.timestamp=(uint32_t []){0},
			.type_specific.num={
				.min=-300,
				.max=300,
				.factor=0.01,
				.offset=0,
				.value=(raw32_t []){{.ui=0}, },
			},
		}},
			(const candb_msg_field_t []){{
			.description={.name="Curr_DCDC_out", .comments="LV Current"},
			.type=CANDB_MSG_FIELD_TYPE_UINT,
			.unit="A",
			.bits=8,
			.offset=48,
			.count=1,
			.timestamp=(uint32_t []){0},
			.type_specific.num={
				.min=0,
				.max=25.5,
				.factor=0.1,
				.offset=0,
				.value=(raw32_t []){{.ui=0}, },
			},
		}},
			(const candb_msg_field_t []){{
			.description={.name="Curr_FANS", .comments="Fans current"},
			.type=CANDB_MSG_FIELD_TYPE_UINT,
			.unit="A",
			.bits=8,
			.offset=56,
			.count=1,
			.timestamp=(uint32_t []){0},
			.type_specific.num={
				.min=0,
				.max=25.5,
				.factor=0.1,
				.offset=0,
				.value=(raw32_t []){{.ui=0}, },
			},
		}},
	NULL}//end of fields array
	}},//end of message struct
	(candb_msg_t []){{
	.callback=(candb_msg_callback_p[]){NULL},
	.timestamp=(uint32_t []){0},
	.description={.name="Estimation", .comments="Calculated data in ACP"},
	.sent_by="ECUA",
	.id=916,
	.length=5,
	.timeout=500,
	.period=0,
	.fields=(const candb_msg_field_t *const[]){
			(const candb_msg_field_t []){{
			.description={.name="Charge_OUT", .comments="Charge lost in motoring"},
			.type=CANDB_MSG_FIELD_TYPE_UINT,
			.unit="mAh",
			.bits=16,
			.offset=0,
			.count=1,
			.timestamp=(uint32_t []){0},
			.type_specific.num={
				.min=0,
				.max=26000,
				.factor=0.5,
				.offset=0,
				.value=(raw32_t []){{.ui=0}, },
			},
		}},
			(const candb_msg_field_t []){{
			.description={.name="Charge_IN", .comments="Charge reccuperated"},
			.type=CANDB_MSG_FIELD_TYPE_UINT,
			.unit="mAh",
			.bits=16,
			.offset=16,
			.count=1,
			.timestamp=(uint32_t []){0},
			.type_specific.num={
				.min=0,
				.max=26000,
				.factor=0.5,
				.offset=0,
				.value=(raw32_t []){{.ui=0}, },
			},
		}},
			(const candb_msg_field_t []){{
			.description={.name="SOC", .comments="State of charge estimation"},
			.type=CANDB_MSG_FIELD_TYPE_UINT,
			.unit="%",
			.bits=8,
			.offset=32,
			.count=1,
			.timestamp=(uint32_t []){0},
			.type_specific.num={
				.min=0,
				.max=105,
				.factor=0.5,
				.offset=0,
				.value=(raw32_t []){{.ui=0}, },
			},
		}},
	NULL}//end of fields array
	}},//end of message struct
	(candb_msg_t []){{
	.callback=(candb_msg_callback_p[]){NULL},
	.timestamp=(uint32_t []){0},
	.description={.name="BalancingStatus", .comments=""},
	.sent_by="ECUA",
	.id=1172,
	.length=8,
	.timeout=0,
	.period=0,
	.fields=(const candb_msg_field_t *const[]){
			(const candb_msg_field_t []){{
			.description={.name="active", .comments=""},
			.type=CANDB_MSG_FIELD_TYPE_BOOL,
			.unit="",
			.bits=1,
			.offset=0,
			.count=12,
			.timestamp=(uint32_t []){0},
			.type_specific.bl={
				.value=(bool []){false, false, false, false, false, false, false, false, false, false, false, false, },
			},
		}},
			(const candb_msg_field_t []){{
			.description={.name="cellIndex", .comments=""},
			.type=CANDB_MSG_FIELD_TYPE_UINT,
			.unit="",
			.bits=4,
			.offset=16,
			.count=12,
			.timestamp=(uint32_t []){0},
			.type_specific.num={
				.min=0,
				.max=15,
				.factor= +1,
				.offset= +0,
				.value=(raw32_t []){{.ui=0}, {.ui=0}, {.ui=0}, {.ui=0}, {.ui=0}, {.ui=0}, {.ui=0}, {.ui=0}, {.ui=0}, {.ui=0}, {.ui=0}, {.ui=0}, },
			},
		}},
	NULL}//end of fields array
	}},//end of message struct
	(candb_msg_t []){{
	.callback=(candb_msg_callback_p[]){NULL},
	.timestamp=(uint32_t []){0},
	.description={.name="BalancingStatus2", .comments=""},
	.sent_by="ECUA",
	.id=1173,
	.length=6,
	.timeout=0,
	.period=0,
	.fields=(const candb_msg_field_t *const[]){
			(const candb_msg_field_t []){{
			.description={.name="Vtarget", .comments=""},
			.type=CANDB_MSG_FIELD_TYPE_UINT,
			.unit="mV",
			.bits=16,
			.offset=0,
			.count=1,
			.timestamp=(uint32_t []){0},
			.type_specific.num={
				.min=0,
				.max=4500,
				.factor=0.1,
				.offset=0,
				.value=(raw32_t []){{.ui=0}, },
			},
		}},
			(const candb_msg_field_t []){{
			.description={.name="AllowedVdiff", .comments=""},
			.type=CANDB_MSG_FIELD_TYPE_UINT,
			.unit="mV",
			.bits=16,
			.offset=16,
			.count=1,
			.timestamp=(uint32_t []){0},
			.type_specific.num={
				.min=0,
				.max=450,
				.factor=0.1,
				.offset=0,
				.value=(raw32_t []){{.ui=0}, },
			},
		}},
			(const candb_msg_field_t []){{
			.description={.name="TimeSinceLastDchg", .comments=""},
			.type=CANDB_MSG_FIELD_TYPE_UINT,
			.unit="ms",
			.bits=16,
			.offset=32,
			.count=1,
			.timestamp=(uint32_t []){0},
			.type_specific.num={
				.min=0,
				.max=65535,
				.factor=1,
				.offset=0,
				.value=(raw32_t []){{.ui=0}, },
			},
		}},
	NULL}//end of fields array
	}},//end of message struct
	(candb_msg_t []){{
	.callback=(candb_msg_callback_p[]){NULL},
	.timestamp=(uint32_t []){0},
	.description={.name="AMSVolts", .comments="AMS message for voltages. Uses multiplexors for identifications of dataset. AMS measures all stacks in the same time but sent that in specific order determined by muxing."},
	.sent_by="ECUA",
	.id=1174,
	.length=7,
	.timeout=50,
	.period=0,
	.fields=(const candb_msg_field_t *const[]){
			(const candb_msg_field_t []){{
			.description={.name="StackID", .comments="Index of stack in ACP - mx"},
			.type=CANDB_MSG_FIELD_TYPE_MUX,
			.unit="",
			.bits=4,
			.offset=0,
			.count=1,
			.timestamp=(uint32_t []){0},
			.type_specific.mux={
				.min=0,
				.max=5,
				.value=(uint8_t []){0},
				.muxed_fields=(const candb_msg_field_t *const *const[5]){
			(const candb_msg_field_t *const[]){
				(const candb_msg_field_t []){{
				.description={.name="SetID", .comments="Index of parallel cell group measurement  in stack - mx"},
				.type=CANDB_MSG_FIELD_TYPE_MUX,
				.unit="",
				.bits=4,
				.offset=4,
				.count=1,
				.timestamp=(uint32_t []){0},
				.type_specific.mux={
					.min=0,
					.max=8,
					.value=(uint8_t []){0},
					.muxed_fields=(const candb_msg_field_t *const *const[8]){
				(const candb_msg_field_t *const[]){
					(const candb_msg_field_t []){{
					.description={.name="Timestamp", .comments="Timestamp of cell measurements"},
					.type=CANDB_MSG_FIELD_TYPE_UINT,
					.unit="ms",
					.bits=16,
					.offset=8,
					.count=1,
					.timestamp=(uint32_t []){0},
					.type_specific.num={
						.min=0,
						.max=65535,
						.factor=1,
						.offset=0,
						.value=(raw32_t []){{.ui=0}, },
					},
				}},
					(const candb_msg_field_t []){{
					.description={.name="Volt", .comments="Voltages of cell sets in parralel"},
					.type=CANDB_MSG_FIELD_TYPE_UINT,
					.unit="mV",
					.bits=16,
					.offset=40,
					.count=2,
					.timestamp=(uint32_t []){0},
					.type_specific.num={
						.min=0,
						.max=4350,
						.factor=0.1,
						.offset=0,
						.value=(raw32_t []){{.ui=0}, {.ui=0}, },
					},
				}},
				NULL},//end of muxed group array
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
	NULL}//end of fields array
	}},//end of message struct
	(candb_msg_t []){{
	.callback=(candb_msg_callback_p[]){NULL},
	.timestamp=(uint32_t []){0},
	.description={.name="AMSTemp", .comments="AMS message for temperatures. Uses multiplexors for identification of dataset."},
	.sent_by="ECUA",
	.id=1175,
	.length=7,
	.timeout=50,
	.period=0,
	.fields=(const candb_msg_field_t *const[]){
			(const candb_msg_field_t []){{
			.description={.name="StackID", .comments="Index of stack in ACP - mx"},
			.type=CANDB_MSG_FIELD_TYPE_MUX,
			.unit="",
			.bits=4,
			.offset=0,
			.count=1,
			.timestamp=(uint32_t []){0},
			.type_specific.mux={
				.min=0,
				.max=5,
				.value=(uint8_t []){0},
				.muxed_fields=(const candb_msg_field_t *const *const[5]){
			(const candb_msg_field_t *const[]){
				(const candb_msg_field_t []){{
				.description={.name="SetID", .comments="Index of measurement in stack - mx"},
				.type=CANDB_MSG_FIELD_TYPE_MUX,
				.unit="",
				.bits=4,
				.offset=4,
				.count=1,
				.timestamp=(uint32_t []){0},
				.type_specific.mux={
					.min=0,
					.max=10,
					.value=(uint8_t []){0},
					.muxed_fields=(const candb_msg_field_t *const *const[10]){
				(const candb_msg_field_t *const[]){
					(const candb_msg_field_t []){{
					.description={.name="Temp", .comments="Temperature measurement"},
					.type=CANDB_MSG_FIELD_TYPE_UINT,
					.unit="°C",
					.bits=8,
					.offset=48,
					.count=6,
					.timestamp=(uint32_t []){0},
					.type_specific.num={
						.min=-25,
						.max=100,
						.factor=0.5,
						.offset=-25,
						.value=(raw32_t []){{.ui=0}, {.ui=0}, {.ui=0}, {.ui=0}, {.ui=0}, {.ui=0}, },
					},
				}},
				NULL},//end of muxed group array
				(const candb_msg_field_t *const[]){
					(const candb_msg_field_t []){{
					.description={.name="Temp", .comments="Temperature measurement"},
					.type=CANDB_MSG_FIELD_TYPE_UINT,
					.unit="°C",
					.bits=8,
					.offset=48,
					.count=6,
					.timestamp=(uint32_t []){0},
					.type_specific.num={
						.min=-25,
						.max=100,
						.factor=0.5,
						.offset=-25,
						.value=(raw32_t []){{.ui=0}, {.ui=0}, {.ui=0}, {.ui=0}, {.ui=0}, {.ui=0}, },
					},
				}},
				NULL},//end of muxed group array
				(const candb_msg_field_t *const[]){
					(const candb_msg_field_t []){{
					.description={.name="Temp", .comments="Temperature measurement"},
					.type=CANDB_MSG_FIELD_TYPE_UINT,
					.unit="°C",
					.bits=8,
					.offset=48,
					.count=6,
					.timestamp=(uint32_t []){0},
					.type_specific.num={
						.min=-25,
						.max=100,
						.factor=0.5,
						.offset=-25,
						.value=(raw32_t []){{.ui=0}, {.ui=0}, {.ui=0}, {.ui=0}, {.ui=0}, {.ui=0}, },
					},
				}},
				NULL},//end of muxed group array
				(const candb_msg_field_t *const[]){
					(const candb_msg_field_t []){{
					.description={.name="Temp", .comments="Temperature measurement"},
					.type=CANDB_MSG_FIELD_TYPE_UINT,
					.unit="°C",
					.bits=8,
					.offset=48,
					.count=6,
					.timestamp=(uint32_t []){0},
					.type_specific.num={
						.min=-25,
						.max=100,
						.factor=0.5,
						.offset=-25,
						.value=(raw32_t []){{.ui=0}, {.ui=0}, {.ui=0}, {.ui=0}, {.ui=0}, {.ui=0}, },
					},
				}},
				NULL},//end of muxed group array
				(const candb_msg_field_t *const[]){
					(const candb_msg_field_t []){{
					.description={.name="Temp", .comments="Temperature measurement"},
					.type=CANDB_MSG_FIELD_TYPE_UINT,
					.unit="°C",
					.bits=8,
					.offset=48,
					.count=6,
					.timestamp=(uint32_t []){0},
					.type_specific.num={
						.min=-25,
						.max=100,
						.factor=0.5,
						.offset=-25,
						.value=(raw32_t []){{.ui=0}, {.ui=0}, {.ui=0}, {.ui=0}, {.ui=0}, {.ui=0}, },
					},
				}},
				NULL},//end of muxed group array
				(const candb_msg_field_t *const[]){
					(const candb_msg_field_t []){{
					.description={.name="Temp", .comments="Temperature measurement"},
					.type=CANDB_MSG_FIELD_TYPE_UINT,
					.unit="°C",
					.bits=8,
					.offset=48,
					.count=6,
					.timestamp=(uint32_t []){0},
					.type_specific.num={
						.min=-25,
						.max=100,
						.factor=0.5,
						.offset=-25,
						.value=(raw32_t []){{.ui=0}, {.ui=0}, {.ui=0}, {.ui=0}, {.ui=0}, {.ui=0}, },
					},
				}},
				NULL},//end of muxed group array
				(const candb_msg_field_t *const[]){
					(const candb_msg_field_t []){{
					.description={.name="Temp", .comments="Temperature measurement"},
					.type=CANDB_MSG_FIELD_TYPE_UINT,
					.unit="°C",
					.bits=8,
					.offset=48,
					.count=6,
					.timestamp=(uint32_t []){0},
					.type_specific.num={
						.min=-25,
						.max=100,
						.factor=0.5,
						.offset=-25,
						.value=(raw32_t []){{.ui=0}, {.ui=0}, {.ui=0}, {.ui=0}, {.ui=0}, {.ui=0}, },
					},
				}},
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
						.min=-25,
						.max=100,
						.factor=0.5,
						.offset=-25,
						.value=(raw32_t []){{.ui=0}, {.ui=0}, {.ui=0}, {.ui=0}, {.ui=0}, {.ui=0}, },
					},
				}},
				NULL},//end of muxed group array
				(const candb_msg_field_t *const[]){
					(const candb_msg_field_t []){{
					.description={.name="Temp", .comments="Temperature measurement"},
					.type=CANDB_MSG_FIELD_TYPE_UINT,
					.unit="°C",
					.bits=8,
					.offset=48,
					.count=6,
					.timestamp=(uint32_t []){0},
					.type_specific.num={
						.min=-25,
						.max=100,
						.factor=0.5,
						.offset=-25,
						.value=(raw32_t []){{.ui=0}, {.ui=0}, {.ui=0}, {.ui=0}, {.ui=0}, {.ui=0}, },
					},
				}},
				NULL},//end of muxed group array
				(const candb_msg_field_t *const[]){
					(const candb_msg_field_t []){{
					.description={.name="Temp", .comments="Temperature measurement"},
					.type=CANDB_MSG_FIELD_TYPE_UINT,
					.unit="°C",
					.bits=8,
					.offset=48,
					.count=6,
					.timestamp=(uint32_t []){0},
					.type_specific.num={
						.min=-25,
						.max=100,
						.factor=0.5,
						.offset=-25,
						.value=(raw32_t []){{.ui=0}, {.ui=0}, {.ui=0}, {.ui=0}, {.ui=0}, {.ui=0}, },
					},
				}},
				NULL},//end of muxed group array
				(const candb_msg_field_t *const[]){
					(const candb_msg_field_t []){{
					.description={.name="Temp", .comments="Temperature measurement"},
					.type=CANDB_MSG_FIELD_TYPE_UINT,
					.unit="°C",
					.bits=8,
					.offset=48,
					.count=6,
					.timestamp=(uint32_t []){0},
					.type_specific.num={
						.min=-25,
						.max=100,
						.factor=0.5,
						.offset=-25,
						.value=(raw32_t []){{.ui=0}, {.ui=0}, {.ui=0}, {.ui=0}, {.ui=0}, {.ui=0}, },
					},
				}},
				NULL},//end of muxed group array
				(const candb_msg_field_t *const[]){
					(const candb_msg_field_t []){{
					.description={.name="Temp", .comments="Temperature measurement"},
					.type=CANDB_MSG_FIELD_TYPE_UINT,
					.unit="°C",
					.bits=8,
					.offset=48,
					.count=6,
					.timestamp=(uint32_t []){0},
					.type_specific.num={
						.min=-25,
						.max=100,
						.factor=0.5,
						.offset=-25,
						.value=(raw32_t []){{.ui=0}, {.ui=0}, {.ui=0}, {.ui=0}, {.ui=0}, {.ui=0}, },
					},
				}},
				NULL},//end of muxed group array
				} //end of muxed groups array
				},//end of mux field init
				}},//end of MUX field struct
			NULL},//end of muxed group array
			} //end of muxed groups array
			},//end of mux field init
			}},//end of MUX field struct
	NULL}//end of fields array
	}},//end of message struct
	(candb_msg_t []){{
	.callback=(candb_msg_callback_p[]){NULL},
	.timestamp=(uint32_t []){0},
	.description={.name="AMSStack", .comments="BMS status for each stack Not recommended for new designs (obsolete)"},
	.sent_by="ECUA",
	.id=1176,
	.length=7,
	.timeout=0,
	.period=0,
	.fields=(const candb_msg_field_t *const[]){
			(const candb_msg_field_t []){{
			.description={.name="StackID", .comments="Index of stack in ACP - multiplexed"},
			.type=CANDB_MSG_FIELD_TYPE_MUX,
			.unit="",
			.bits=4,
			.offset=0,
			.count=1,
			.timestamp=(uint32_t []){0},
			.type_specific.mux={
				.min=0,
				.max=9,
				.value=(uint8_t []){0},
				.muxed_fields=(const candb_msg_field_t *const *const[9]){
			(const candb_msg_field_t *const[]){
				(const candb_msg_field_t []){{
				.description={.name="Volt_Min", .comments="Maximum AMS stack cell voltage"},
				.type=CANDB_MSG_FIELD_TYPE_UINT,
				.unit="V",
				.bits=16,
				.offset=8,
				.count=1,
				.timestamp=(uint32_t []){0},
				.type_specific.num={
					.min=0,
					.max=4350,
					.factor=0.1,
					.offset=0,
					.value=(raw32_t []){{.ui=0}, },
				},
			}},
				(const candb_msg_field_t []){{
				.description={.name="Volt_Max", .comments="Minimum AMS stack cell voltage"},
				.type=CANDB_MSG_FIELD_TYPE_UINT,
				.unit="V",
				.bits=16,
				.offset=24,
				.count=1,
				.timestamp=(uint32_t []){0},
				.type_specific.num={
					.min=0,
					.max=4350,
					.factor=0.1,
					.offset=0,
					.value=(raw32_t []){{.ui=0}, },
				},
			}},
				(const candb_msg_field_t []){{
				.description={.name="Temp_Max", .comments="Maximum AMS stack cell temperature"},
				.type=CANDB_MSG_FIELD_TYPE_UINT,
				.unit="°C",
				.bits=8,
				.offset=40,
				.count=1,
				.timestamp=(uint32_t []){0},
				.type_specific.num={
					.min=-25,
					.max=100,
					.factor=0.5,
					.offset=-25,
					.value=(raw32_t []){{.ui=0}, },
				},
			}},
				(const candb_msg_field_t []){{
				.description={.name="Temp_Min", .comments="Minimum AMS stack cell temperature"},
				.type=CANDB_MSG_FIELD_TYPE_UINT,
				.unit="°C",
				.bits=8,
				.offset=48,
				.count=1,
				.timestamp=(uint32_t []){0},
				.type_specific.num={
					.min=-25,
					.max=100,
					.factor=0.5,
					.offset=-25,
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
			}},//end of MUX field struct
	NULL}//end of fields array
	}},//end of message struct
	(candb_msg_t []){{
	.callback=(candb_msg_callback_p[]){NULL},
	.timestamp=(uint32_t []){0},
	.description={.name="AMSOverall", .comments="AMS Overal data Auch ein bisschen redundant"},
	.sent_by="ECUA",
	.id=1178,
	.length=8,
	.timeout=0,
	.period=0,
	.fields=(const candb_msg_field_t *const[]){
			(const candb_msg_field_t []){{
			.description={.name="Volt_Max", .comments="Maximum cell voltage over ACP"},
			.type=CANDB_MSG_FIELD_TYPE_UINT,
			.unit="mV",
			.bits=16,
			.offset=0,
			.count=1,
			.timestamp=(uint32_t []){0},
			.type_specific.num={
				.min=0,
				.max=4350,
				.factor=0.1,
				.offset= +0,
				.value=(raw32_t []){{.ui=0}, },
			},
		}},
			(const candb_msg_field_t []){{
			.description={.name="Volt_Min", .comments="Minimum cell voltage over ACP"},
			.type=CANDB_MSG_FIELD_TYPE_UINT,
			.unit="mV",
			.bits=16,
			.offset=16,
			.count=1,
			.timestamp=(uint32_t []){0},
			.type_specific.num={
				.min=0,
				.max=4350,
				.factor=0.1,
				.offset= +0,
				.value=(raw32_t []){{.ui=0}, },
			},
		}},
			(const candb_msg_field_t []){{
			.description={.name="Temp_Min", .comments="Maximum cell temperature over ACP"},
			.type=CANDB_MSG_FIELD_TYPE_INT,
			.unit="°C",
			.bits=8,
			.offset=32,
			.count=1,
			.timestamp=(uint32_t []){0},
			.type_specific.num={
				.min=-128,
				.max=127,
				.factor=1,
				.offset=0,
				.value=(raw32_t []){{.si=0}, },
			},
		}},
			(const candb_msg_field_t []){{
			.description={.name="Temp_Max", .comments="Minimum cell temperature over ACP"},
			.type=CANDB_MSG_FIELD_TYPE_UINT,
			.unit="°C",
			.bits=8,
			.offset=40,
			.count=1,
			.timestamp=(uint32_t []){0},
			.type_specific.num={
				.min=-25,
				.max=230,
				.factor=0.5,
				.offset=-25,
				.value=(raw32_t []){{.ui=0}, },
			},
		}},
			(const candb_msg_field_t []){{
			.description={.name="Temp_Max_Index", .comments="Maximum cell index"},
			.type=CANDB_MSG_FIELD_TYPE_UINT,
			.unit="?",
			.bits=8,
			.offset=48,
			.count=1,
			.timestamp=(uint32_t []){0},
			.type_specific.num={
				.min= +0,
				.max= +0,
				.factor= +1,
				.offset= +0,
				.value=(raw32_t []){{.ui=0}, },
			},
		}},
			(const candb_msg_field_t []){{
			.description={.name="Volt_Min_index", .comments="Minimum cell index"},
			.type=CANDB_MSG_FIELD_TYPE_UINT,
			.unit="?",
			.bits=8,
			.offset=56,
			.count=1,
			.timestamp=(uint32_t []){0},
			.type_specific.num={
				.min= +0,
				.max= +0,
				.factor= +1,
				.offset= +0,
				.value=(raw32_t []){{.ui=0}, },
			},
		}},
	NULL}//end of fields array
	}},//end of message struct
	(candb_msg_t []){{
	.callback=(candb_msg_callback_p[]){NULL},
	.timestamp=(uint32_t []){0},
	.description={.name="Voltages", .comments="Accumulator voltage information."},
	.sent_by="ECUA",
	.id=917,
	.length=7,
	.timeout=5000,
	.period=0,
	.fields=(const candb_msg_field_t *const[]){
			(const candb_msg_field_t []){{
			.description={.name="Uin", .comments="Voltage on accumulator stacks"},
			.type=CANDB_MSG_FIELD_TYPE_UINT,
			.unit="V",
			.bits=24,
			.offset=0,
			.count=1,
			.timestamp=(uint32_t []){0},
			.type_specific.num={
				.min= +0,
				.max= +0,
				.factor=0.001,
				.offset=0,
				.value=(raw32_t []){{.ui=0}, },
			},
		}},
			(const candb_msg_field_t []){{
			.description={.name="Uout", .comments="Voltage on AIRs outut"},
			.type=CANDB_MSG_FIELD_TYPE_UINT,
			.unit="V",
			.bits=24,
			.offset=24,
			.count=1,
			.timestamp=(uint32_t []){0},
			.type_specific.num={
				.min= +0,
				.max= +0,
				.factor=0.001,
				.offset=0,
				.value=(raw32_t []){{.ui=0}, },
			},
		}},
	NULL}//end of fields array
	}},//end of message struct
	(candb_msg_t []){{
	.callback=(candb_msg_callback_p[]){NULL},
	.timestamp=(uint32_t []){0},
	.description={.name="ChargerHeartbeat", .comments="Hotfix for a missing interlock. Sent by ECUA to CCU."},
	.sent_by="ECUA",
	.id=923,
	.length=2,
	.timeout=1000,
	.period=0,
	.fields=(const candb_msg_field_t *const[]){
			(const candb_msg_field_t []){{
			.description={.name="HBprmb", .comments="preambula (magic number)"},
			.type=CANDB_MSG_FIELD_TYPE_UINT,
			.unit="",
			.bits=8,
			.offset=0,
			.count=1,
			.timestamp=(uint32_t []){0},
			.type_specific.num={
				.min=0xAA,
				.max=0xAA,
				.factor= +1,
				.offset= +0,
				.value=(raw32_t []){{.ui=0}, },
			},
		}},
			(const candb_msg_field_t []){{
			.description={.name="ready", .comments="1 of AIRs are closed correctly, zero otherwise"},
			.type=CANDB_MSG_FIELD_TYPE_UINT,
			.unit="0",
			.bits=8,
			.offset=8,
			.count=1,
			.timestamp=(uint32_t []){0},
			.type_specific.num={
				.min=0,
				.max=1,
				.factor=0,
				.offset=0,
				.value=(raw32_t []){{.ui=0}, },
			},
		}},
	NULL}//end of fields array
	}},//end of message struct
	(candb_msg_t []){{
	.callback=(candb_msg_callback_p[]){NULL},
	.timestamp=(uint32_t []){0},
	.description={.name="Status", .comments="ECUB Status report"},
	.sent_by="ECUB",
	.id=160,
	.length=8,
	.timeout=1000,
	.period=0,
	.fields=(const candb_msg_field_t *const[]){
			(const candb_msg_field_t []){{
			.description={.name="SDC_FRONT", .comments="Shutdown circuit - Front"},
			.type=CANDB_MSG_FIELD_TYPE_BOOL,
			.unit="",
			.bits=1,
			.offset=0,
			.count=1,
			.timestamp=(uint32_t []){0},
			.type_specific.bl={
				.value=(bool []){false, },
			},
		}},
			(const candb_msg_field_t []){{
			.description={.name="SDC_SDBL", .comments="Shutdown circuit - Shutdown button left"},
			.type=CANDB_MSG_FIELD_TYPE_BOOL,
			.unit="",
			.bits=1,
			.offset=1,
			.count=1,
			.timestamp=(uint32_t []){0},
			.type_specific.bl={
				.value=(bool []){false, },
			},
		}},
			(const candb_msg_field_t []){{
			.description={.name="SDC_SDBR", .comments="Shutdown circuit - Shutdown button right"},
			.type=CANDB_MSG_FIELD_TYPE_BOOL,
			.unit="",
			.bits=1,
			.offset=2,
			.count=1,
			.timestamp=(uint32_t []){0},
			.type_specific.bl={
				.value=(bool []){false, },
			},
		}},
			(const candb_msg_field_t []){{
			.description={.name="SDC_HVD", .comments="Shutdown circuit - High voltage disconnect"},
			.type=CANDB_MSG_FIELD_TYPE_BOOL,
			.unit="",
			.bits=1,
			.offset=3,
			.count=1,
			.timestamp=(uint32_t []){0},
			.type_specific.bl={
				.value=(bool []){false, },
			},
		}},
			(const candb_msg_field_t []){{
			.description={.name="SDC_BSPD", .comments="Shutdown circuit - Brake plausibility device"},
			.type=CANDB_MSG_FIELD_TYPE_BOOL,
			.unit="",
			.bits=1,
			.offset=4,
			.count=1,
			.timestamp=(uint32_t []){0},
			.type_specific.bl={
				.value=(bool []){false, },
			},
		}},
			(const candb_msg_field_t []){{
			.description={.name="SDC_MCUR", .comments="Shutdown circuit - Motor controller rear"},
			.type=CANDB_MSG_FIELD_TYPE_BOOL,
			.unit="",
			.bits=1,
			.offset=5,
			.count=1,
			.timestamp=(uint32_t []){0},
			.type_specific.bl={
				.value=(bool []){false, },
			},
		}},
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
